Mancasvel/FlowSight-ESP32/enclosure/FlowSight-Desk-guia.pdf

FlowSight Desk · Guía de impresión y montaje · 1.1 | 1

# FlowSight Desk

Carcasa imprimible para tu pantalla externa FlowSight. Cuerpo grafito, marca discreta, base abierta y entrada USB a la izquierda. Pantalla orientada hacia ti y hacia arriba, con una inclinación de 25 grados respecto a la vertical.

Render del modelo CAD real. La pantalla muestra una captura de demostración del firmware; no es una fotografía de un producto fabricado.

## 024: 92 × 68 mm · 028: 104 × 74 mm · Base común: 90 × 66 mm

La CS-32 N4XX aún necesita una prueba física de encaje. Su perfil eléctrico no demuestra el tamaño de la placa. Imprime primero la plantilla pequeña antes de una carcasa completa o de fabricar un lote.

# Orientación de uso

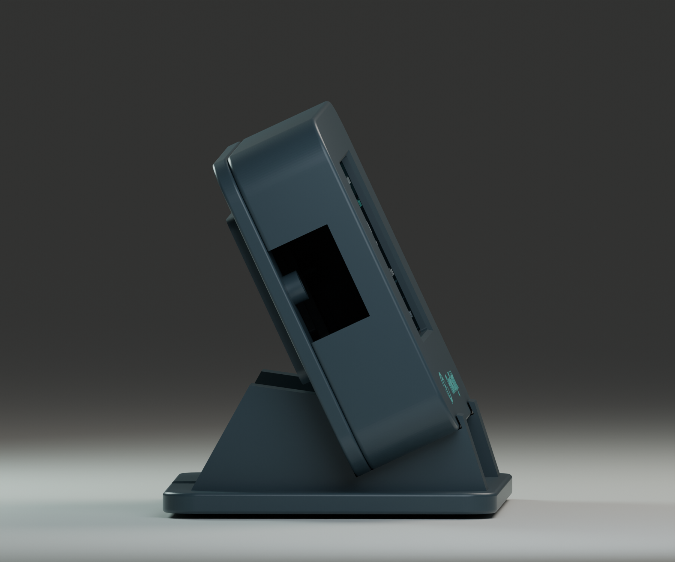
[picture p3: figure]

Vista lateral del CAD: el borde superior se retrasa y la cara de la pantalla apunta 25 grados hacia arriba. El frontal forma 65 grados con la mesa. Los dos apoyos dejan el centro y la parte trasera abiertos.

Los STEP muestran el conjunto montado. Los STL y 3MF están colocados para imprimir: el frontal descansa boca abajo en la cama. Al montarlo se coloca erguido, con la marca debajo de la pantalla y los respaldos altos de la base detrás.

# Elegir e imprimir

Unidad | Referencia y archivo
CS-32 N4XX actual | Referencia 024: placa 74,4 × 42,9 mm, agujeros 68 × 36,5 mm. FlowSight_Desk_CS32_024_reference.3mf
CYD 2,8 pulgadas | Referencia 028: placa hasta 86,6 × 50 mm, agujeros 78 × 42 mm. FlowSight_Desk_CYD_028.3mf

## Primero, la plantilla de encaje

Imprime Fit_check_CS32_024_reference.stl para comprobar la unidad actual. Si la placa es la de 2,8 pulgadas, prueba Fit_check_CYD_028.stl. Verifica los cuatro agujeros y que la ventana deja ver toda el área activa. La plantilla consume aproximadamente 5–6 g de PETG.

## Ajustes iniciales

Ajuste | Recomendación
Material / boquilla | PETG mate grafito / 0,4 mm
Capas / paredes | 0,20 mm / cuatro perímetros / cinco capas arriba y abajo
Relleno | 20 % gyroid; base 25–30 %
Escala / soportes | 100 %, milímetros. Orientación ya incluida. Sin soportes previstos; revisar las capas del laminador.
Cama | 024: 190 × 144 mm. 028: 214 × 150 mm. Separar las piezas si hay una zona de exclusión.

Los 3MF contienen cuatro piezas: frontal, tapa, registro de servicio y base. Usa el frontal y la tapa con el mismo sufijo de placa. El registro y la base son comunes. No se incluye G-code porque depende de la impresora y del filamento.

## Marca FlowSight

Símbolo oficial y nombre grabados a 0,6 mm. Una impresora de un solo material puede imprimir el frontal grafito y rellenar el grabado con pintura turquesa. La alternativa multimaterial es Brand_inlay_optional.stl; consultar la posición exacta en README.md.

# Montaje

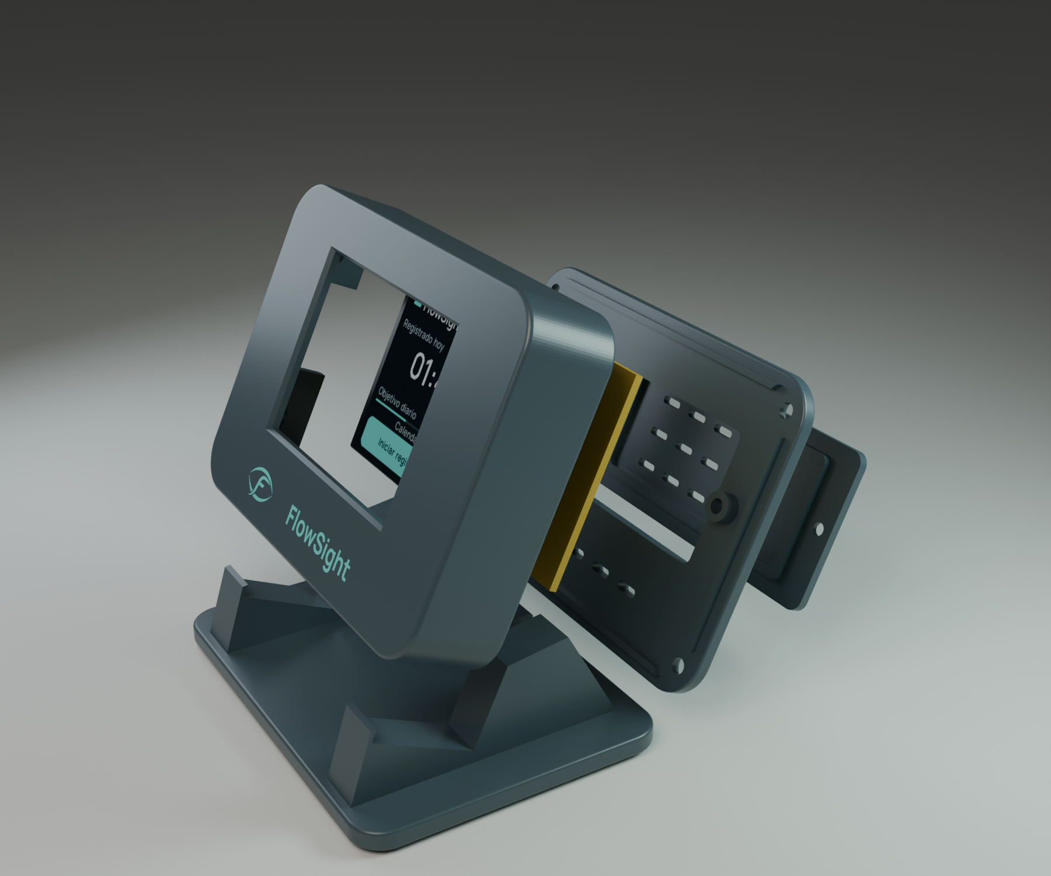
[picture p4: figure]

Vista de piezas separadas. La placa y el LCD se muestran como componentes ilustrativos; las piezas de la carcasa proceden de los STL finales.

Cantidad | Componente
4 + 4 | Insertos M3 de 4,6 × 5 mm y tornillos M3 × 8 mm para la tapa.
6 | Insertos M2,5 de 3,5 × 3 mm: cuatro del PCB, dos del registro.
4 + 2 | Tornillos M2,5 × 4 mm para PCB y M2,5 × 8 mm para registro; cabeza baja.
4 | Pies adhesivos de goma de 10 mm y 1,5–2 mm de grosor.

# Terminar la primera unidad

1. Instala los insertos con la electrónica fuera. Comprueba diámetro y longitud; ajusta los pilotos si tu marca de insertos difiere.
2. Coloca el PCB en los cuatro postes. No presiones el cristal con el frontal. Usa separadores uniformes si necesitas más altura y comprueba que la placa no flexiona al sujetarla.
3. Prueba touch, USB y alcance del cable. La entrada queda a la izquierda mirando la pantalla de frente. El hueco es de 20 × 13 mm; una funda de conector de hasta 18 × 11 mm deja holgura. La posición exacta puede variar entre revisiones.
4. Atornilla la tapa y el registro de servicio. El registro se desmonta para acceder a BOOT, RESET y conectores internos. La base es una cuna desmontable por gravedad.
5. Coloca los pies y comprueba estabilidad al tocar la pantalla. Tras elegir la placa y el cable definitivos, valida también el montaje y la temperatura de uso antes de fabricar un lote.

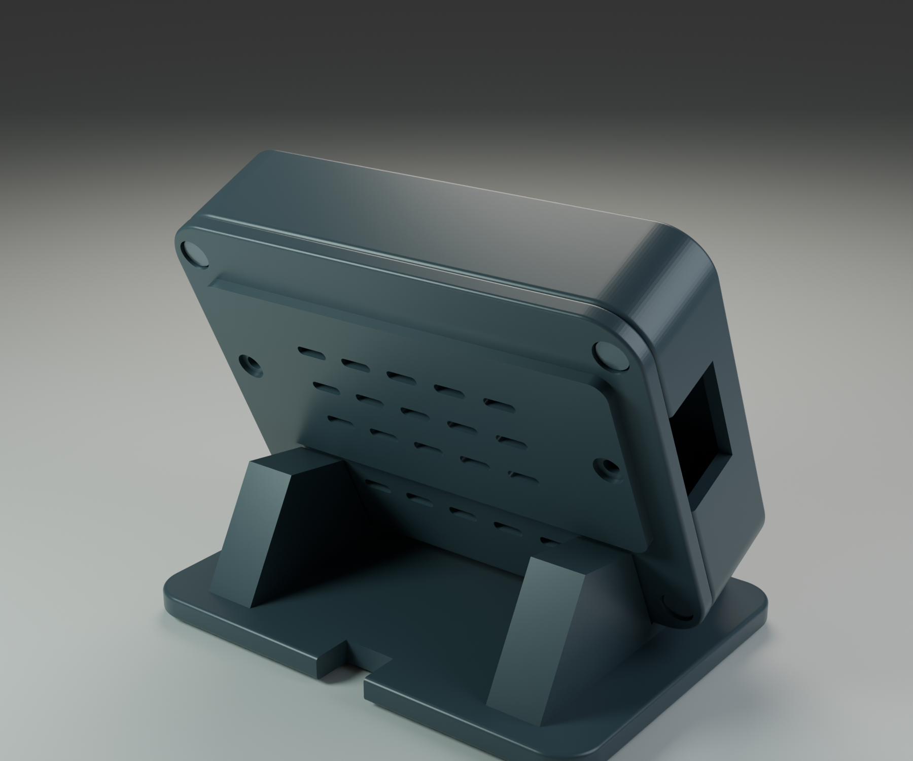
[picture p5: figure]

## Archivos editables

Los STEP de conjunto se encuentran en la carpeta enclosure y los STEP de piezas en source. El diseño paramétrico original es source/build.py y source/parameters.json. README.md incluye reproducción, tolerancias y montaje detallado.
