Mancasvel/FlowSight-ESP32/artifacts/offline-en.png

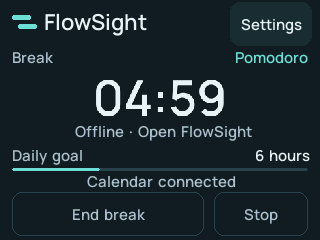
artifacts/offline-en.png
