Mancasvel/FlowSight-ESP32/artifacts/pomodoro-en.png

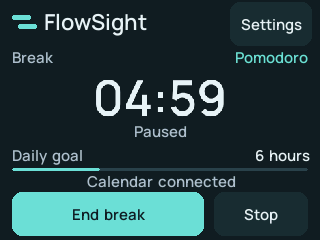
artifacts/pomodoro-en.png
