Mancasvel/FlowSight-ESP32/artifacts/settings-en.png

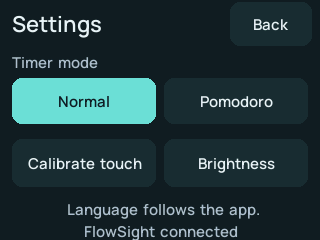
artifacts/settings-en.png
