Mancasvel/FlowSight-ESP32/enclosure/preview/FlowSight-Desk-left.png

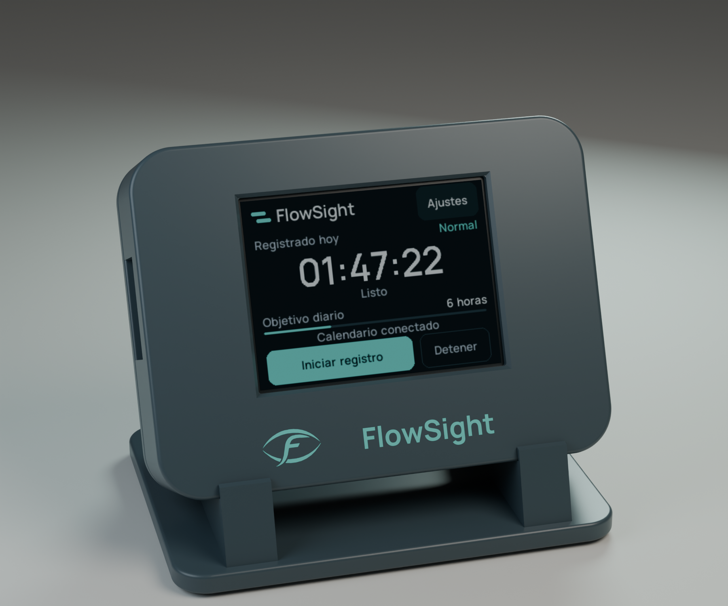
enclosure/preview/FlowSight-Desk-left.png
