Mancasvel/FlowSight-ESP32/enclosure/FlowSight_Desk_CYD_028.step

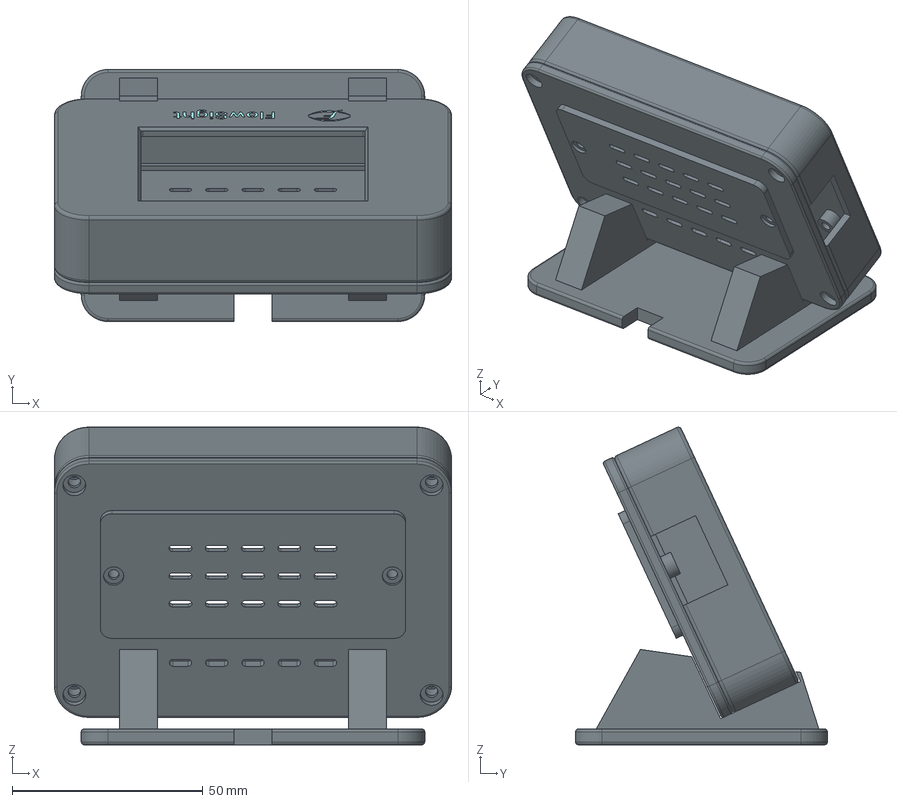
[picture p10: CAD file, 2026-10-12]
enclosure/FlowSight_Desk_CYD_028.step
104.0 x 66.0 x 83.2 mm
front
rear_cover
service_hatch
brand
desk_stand
