Mancasvel/FlowSight-ESP32/enclosure/print/Fit_check_CS32_024_reference.stl

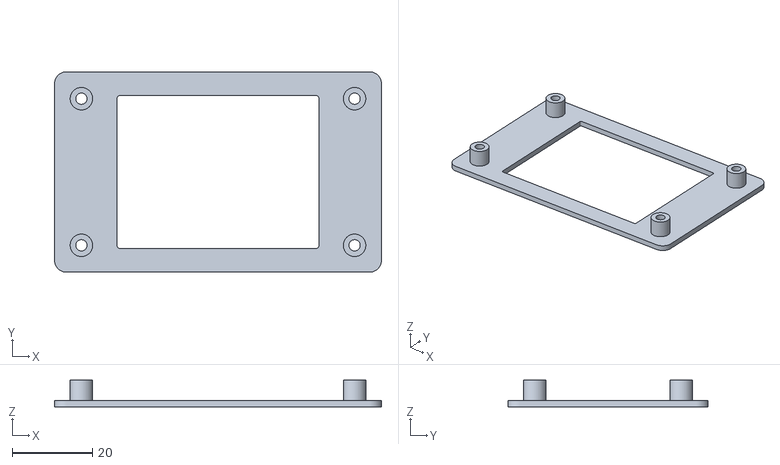
[picture p11: CAD file, 2026-10-12]
enclosure/print/Fit_check_CS32_024_reference.stl
81.4 x 49.9 x 6.60
