Mancasvel/FlowSight-ESP32/enclosure/source/Rear_cover_CYD_028.step

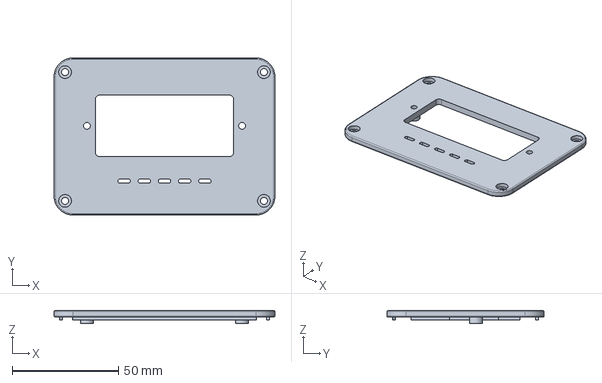
[picture p12: CAD file, 2026-10-12]
enclosure/source/Rear_cover_CYD_028.step
104.0 x 74.0 x 6.20 mm
