Mancasvel/FlowSight-ESP32/enclosure/FlowSight_Desk_CS32_024_reference.step

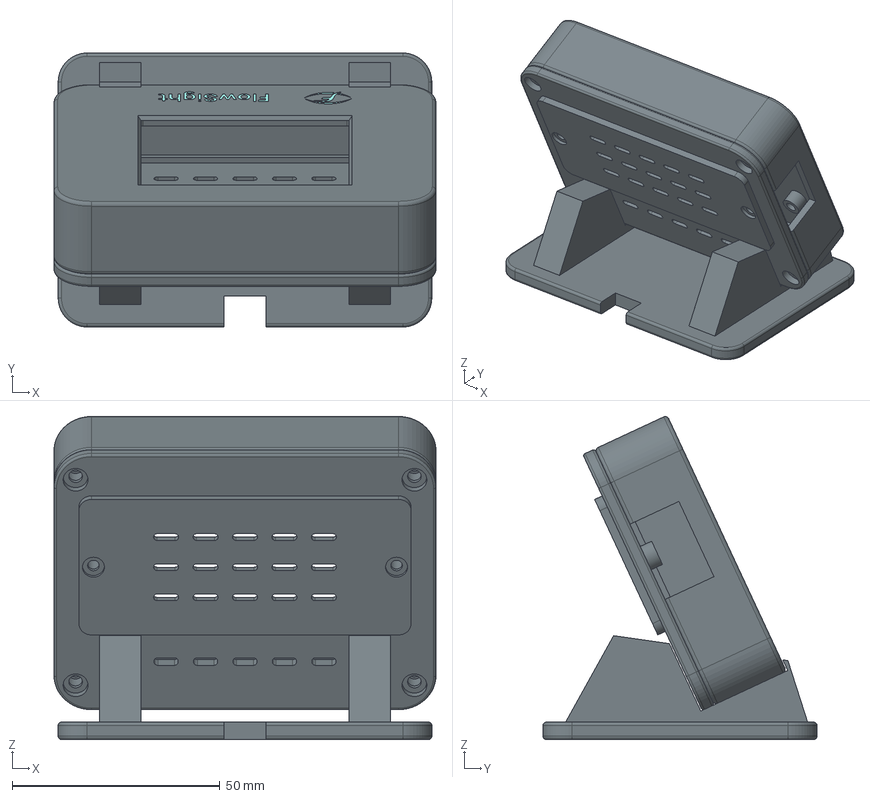
[picture p13: CAD file, 2026-10-12]
enclosure/FlowSight_Desk_CS32_024_reference.step
92.0 x 66.0 x 77.8 mm
front
rear_cover
service_hatch
brand
desk_stand
