Mancasvel/FlowSight-ESP32/enclosure/print/Fit_check_CYD_028.stl

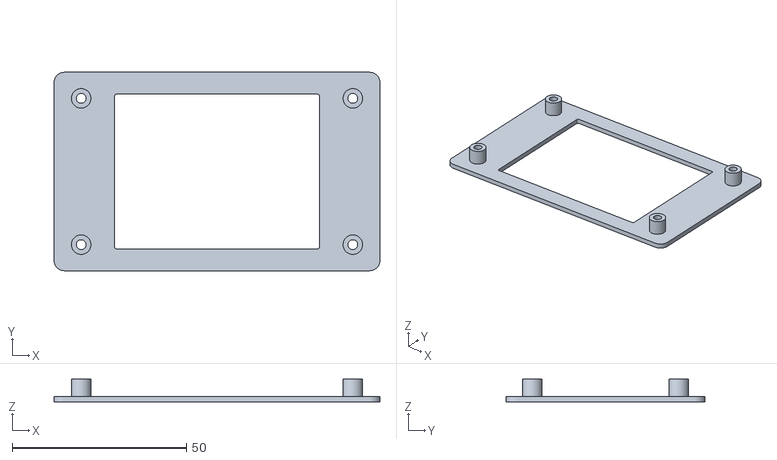
[picture p14: CAD file, 2026-10-12]
enclosure/print/Fit_check_CYD_028.stl
93.6 x 57.0 x 6.60
