Mancasvel/FlowSight-ESP32/enclosure/source/Front_CS32_024_reference.step

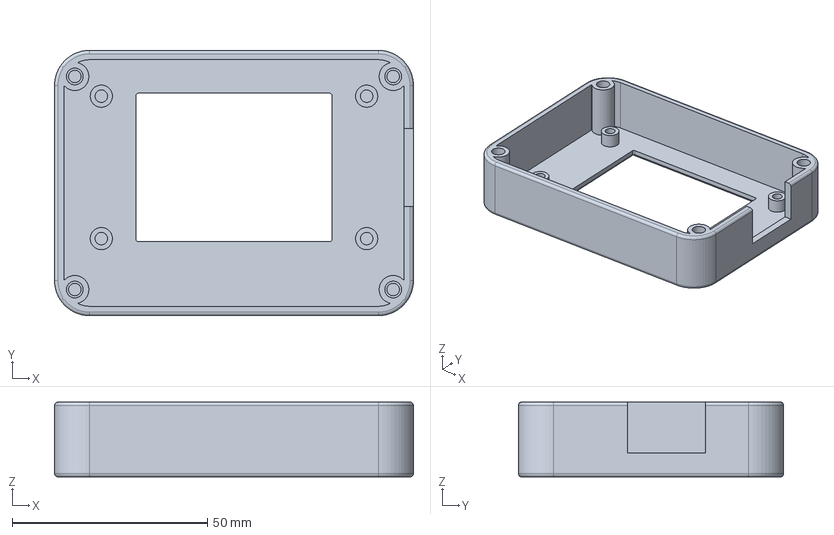
[picture p15: CAD file, 2026-10-12]
enclosure/source/Front_CS32_024_reference.step
92.0 x 68.0 x 19.2 mm
