Mancasvel/FlowSight-ESP32/enclosure/print/Brand_inlay_optional.stl

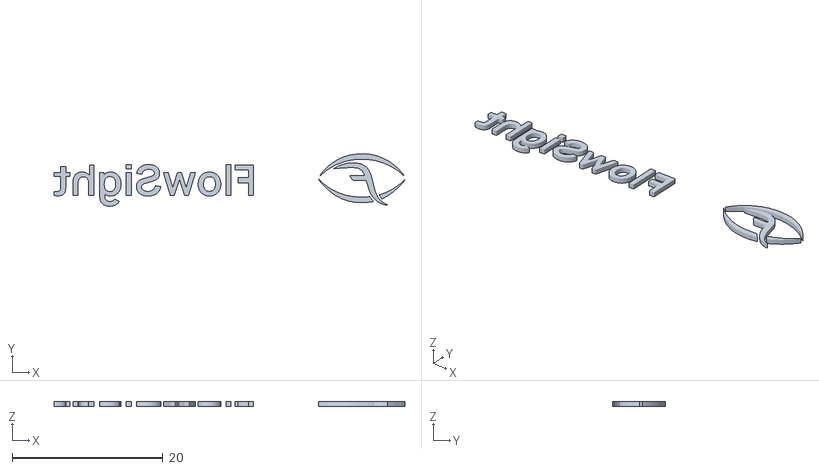
[picture p16: CAD file, 2026-10-12]
enclosure/print/Brand_inlay_optional.stl
46.5 x 6.96 x 0.6
