Mancasvel/FlowSight-ESP32/enclosure/source/Front_CYD_028.step

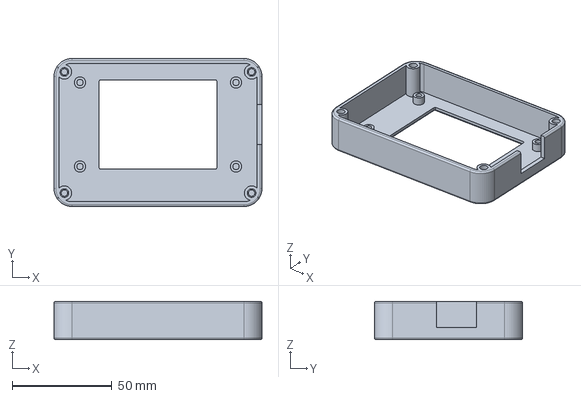
[picture p17: CAD file, 2026-10-12]
enclosure/source/Front_CYD_028.step
104.0 x 74.0 x 19.2 mm
