Mancasvel/FlowSight-ESP32/enclosure/print/PCB_spacer_0p4mm.stl

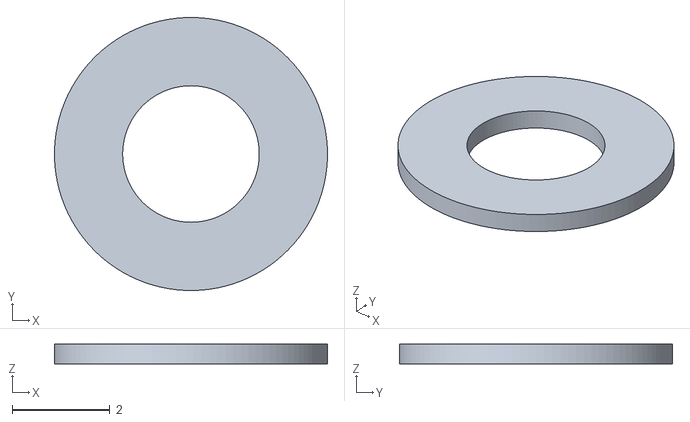
[picture p18: CAD file, 2026-10-11]
enclosure/print/PCB_spacer_0p4mm.stl
5.60 x 5.60 x 0.4
