Mancasvel/FlowSight-ESP32/enclosure/source/Rear_cover_CS32_024_reference.step

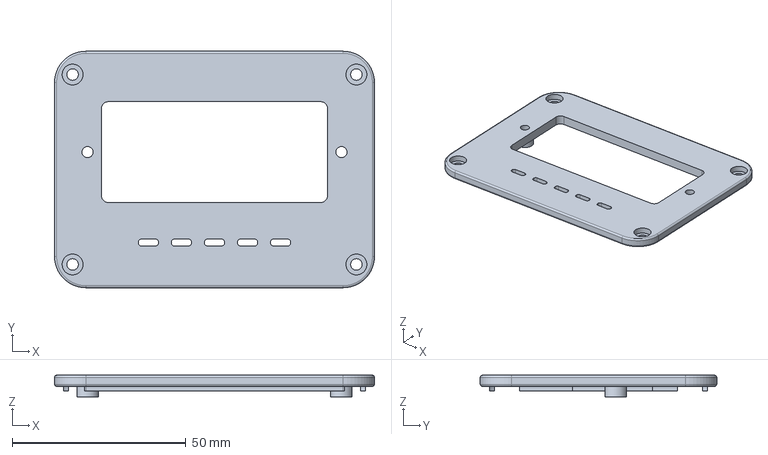
[picture p19: CAD file, 2026-10-12]
enclosure/source/Rear_cover_CS32_024_reference.step
92.0 x 68.0 x 6.20 mm
