Mancasvel/FlowSight-ESP32/enclosure/print/PCB_spacer_0p8mm.stl

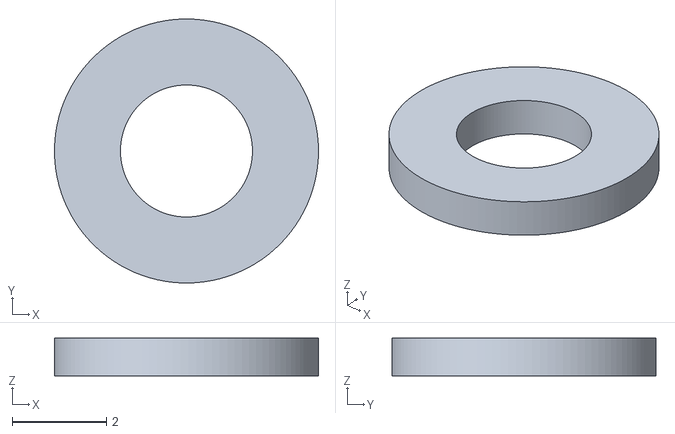
[picture p20: CAD file, 2026-10-11]
enclosure/print/PCB_spacer_0p8mm.stl
5.60 x 5.60 x 0.8
