Mancasvel/FlowSight-ESP32/enclosure/source/Service_hatch.step

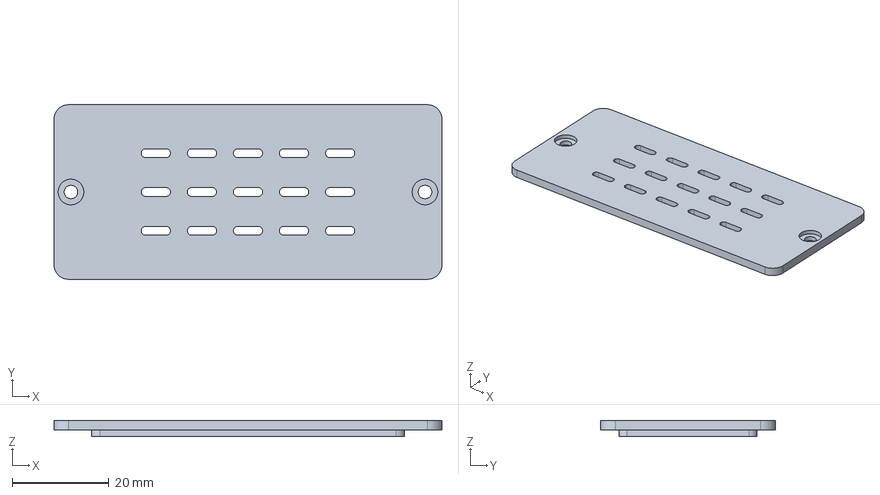
[picture p21: CAD file, 2026-10-12]
enclosure/source/Service_hatch.step
80.0 x 36.0 x 3.30 mm
