Mancasvel/FlowSight-ESP32/enclosure/print/PCB_spacer_1p2mm.stl

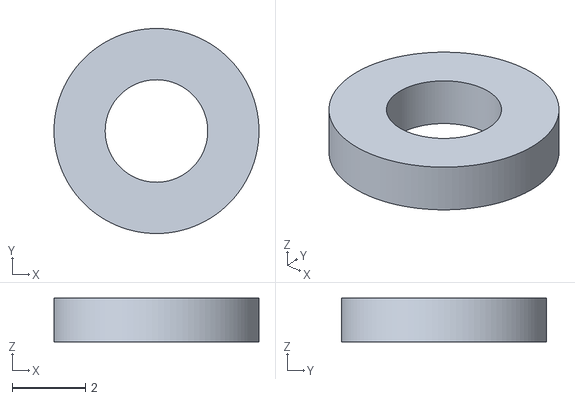
[picture p22: CAD file, 2026-10-11]
enclosure/print/PCB_spacer_1p2mm.stl
5.60 x 5.60 x 1.20
