Mancasvel/FlowSight-ESP32/enclosure/source/Desk_stand_65deg.step

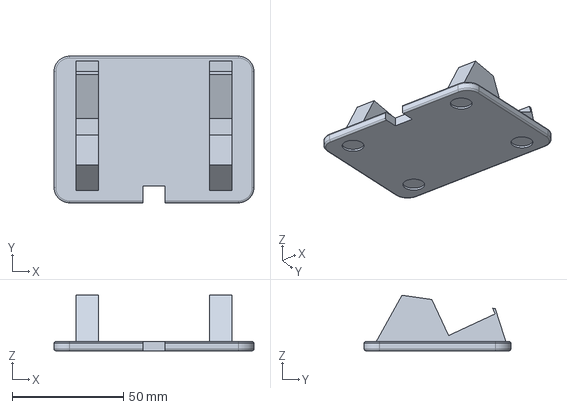
[picture p23: CAD file, 2026-10-12]
enclosure/source/Desk_stand_65deg.step
90.0 x 66.0 x 25.0 mm
