Mancasvel/FlowSight-ESP32/(list of files, cad)

Other CAD files:
enclosure/print/Desk_stand_65deg.stl
enclosure/print/FlowSight_Desk_CS32_024_reference.3mf
enclosure/print/FlowSight_Desk_CYD_028.3mf
enclosure/print/Front_CS32_024_reference.stl
enclosure/print/Front_CYD_028.stl
enclosure/print/Rear_cover_CS32_024_reference.stl
enclosure/print/Rear_cover_CYD_028.stl
enclosure/print/Service_hatch.stl
