Mancasvel/FlowSight-ESP32/(commit log)

2026-10-11 Add native FlowSight timer for ESP32 CYD
2026-10-11 feat: mirror the FlowSight app over USB in firmware 0.2.0
2026-10-11 fix: accept resistive header touches and provide calibration-safe updates
    [Brand_inlay_optional.stl, CYD-028-board.stl, CYD-028-reference.step, Desk_stand_65deg.step, Desk_stand_65deg.stl, Fit_check_CS32_024_reference.stl, Fit_check_CYD_028.stl, FlowSight_Desk_CS32_024_reference.3mf]
2026-10-11 chore: leave ongoing enclosure work outside the firmware release
    [Brand_inlay_optional.stl, CYD-028-board.stl, CYD-028-reference.step, Desk_stand_65deg.step, Desk_stand_65deg.stl, Fit_check_CS32_024_reference.stl, Fit_check_CYD_028.stl, FlowSight_Desk_CS32_024_reference.3mf]
2026-10-11 feat: add FlowSight Desk printable enclosure and assembly guide
    [Brand_inlay_optional.stl, Desk_stand_65deg.step, Desk_stand_65deg.stl, Fit_check_CS32_024_reference.stl, Fit_check_CYD_028.stl, FlowSight_Desk_CS32_024_reference.3mf, FlowSight_Desk_CS32_024_reference.step, FlowSight_Desk_CYD_028.3mf]
2026-10-11 fix: stabilize resistive settings gestures and avoid redundant redraws
    [TouchGesture.h, device.py, main.cpp, touch_gesture.cpp, verify_device.py]
2026-10-12 fix: refine FlowSight Desk and correct left USB orientation
    [Brand_inlay_optional.stl, Desk_stand_65deg.step, Desk_stand_65deg.stl, Fit_check_CS32_024_reference.stl, Fit_check_CYD_028.stl, FlowSight_Desk_CS32_024_reference.3mf, FlowSight_Desk_CS32_024_reference.step, FlowSight_Desk_CYD_028.3mf]
